thelegend107/H-M-Configuration-Dongle/README.md

# Windows Network Config Dongle
Code Deploy
