thelegend107/H-M-Configuration-Dongle/Block Diagram/block_diagram v2.0.io.png

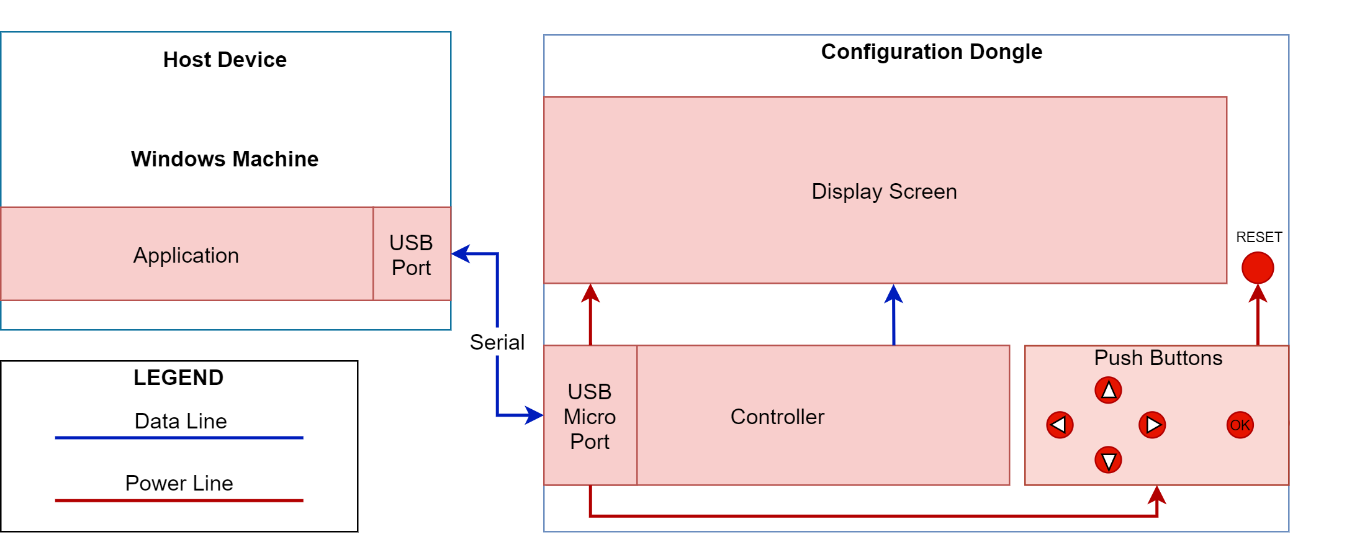
Block Diagram/block_diagram v2.0.io.png
