thelegend107/H-M-Configuration-Dongle/EXPO/Flowcharts & Diagrams/microcontroller process.png

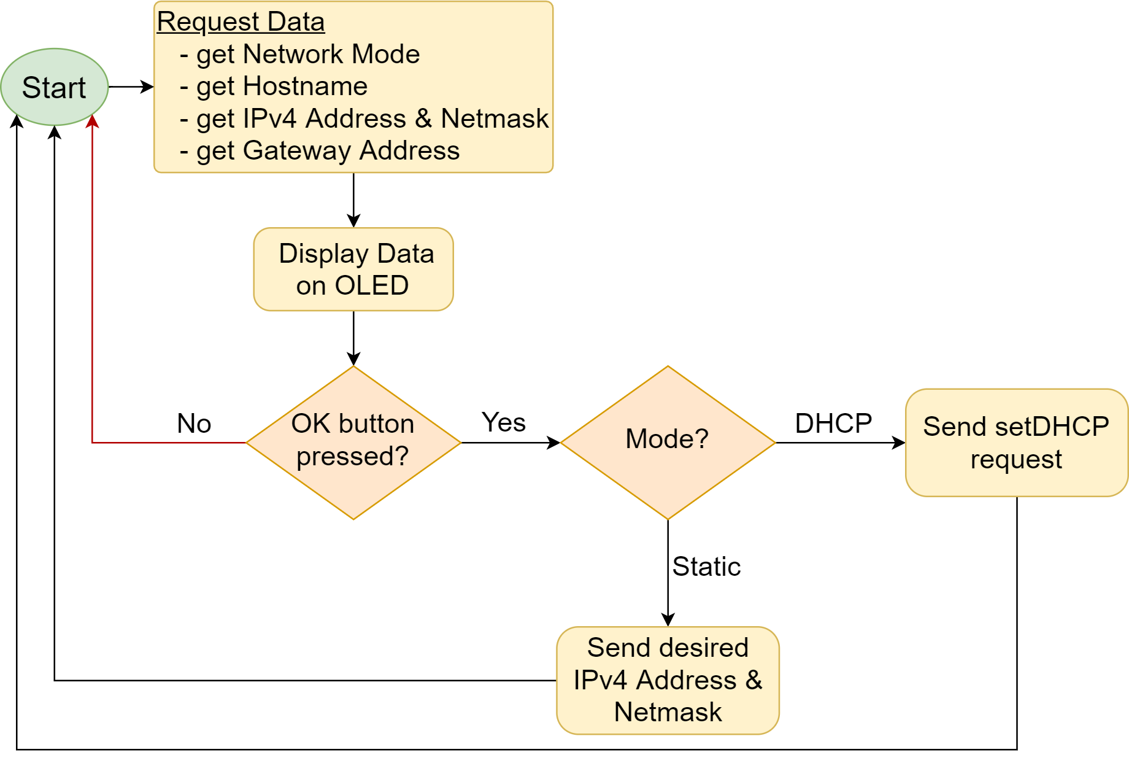
EXPO/Flowcharts & Diagrams/microcontroller process.png
