thelegend107/H-M-Configuration-Dongle/EXPO/Flowcharts & Diagrams/Net_App_Flowchart_noBG.png

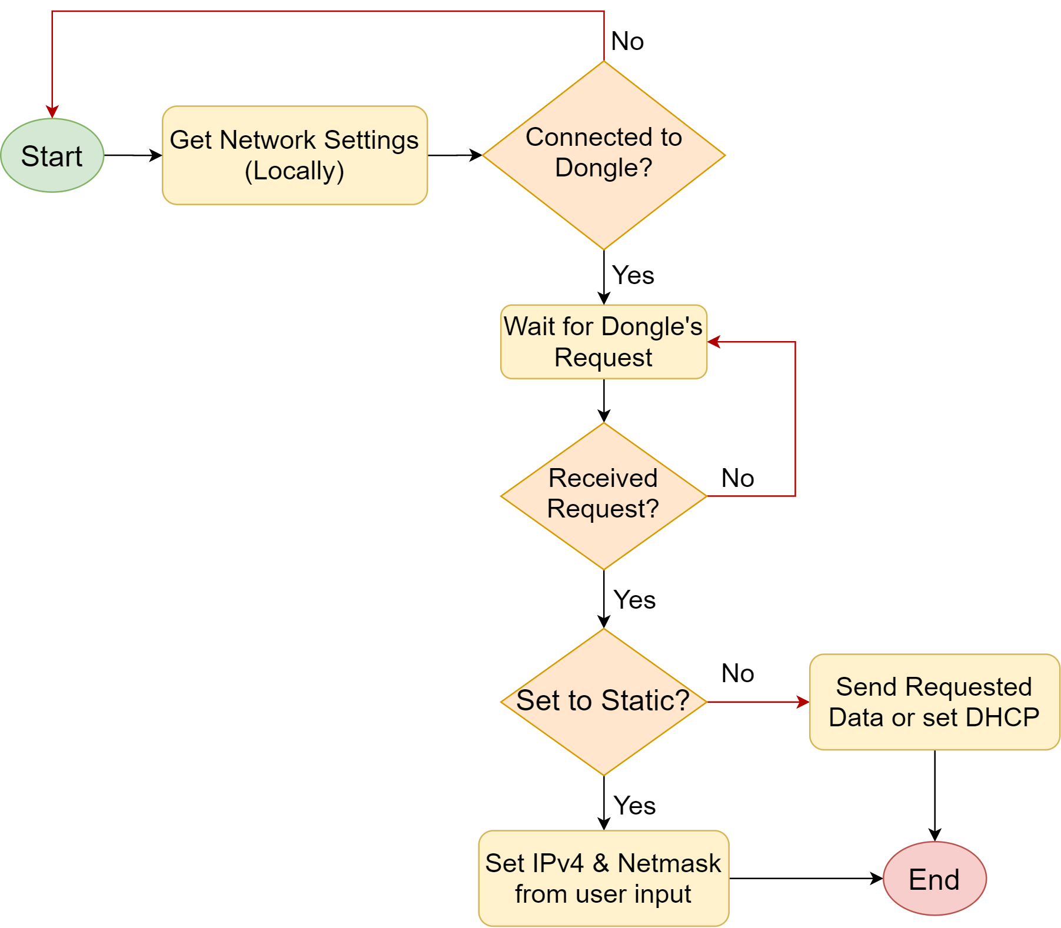
EXPO/Flowcharts & Diagrams/Net_App_Flowchart_noBG.png
