thelegend107/H-M-Configuration-Dongle/PCB/H&M_CD1.png

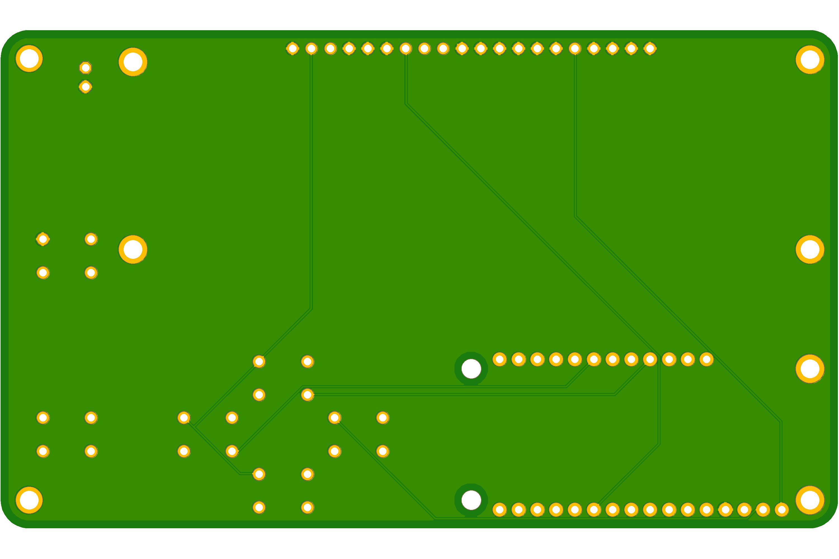
PCB/H&M_CD1.png
