thelegend107/H-M-Configuration-Dongle/PCB/H&M_CD.png

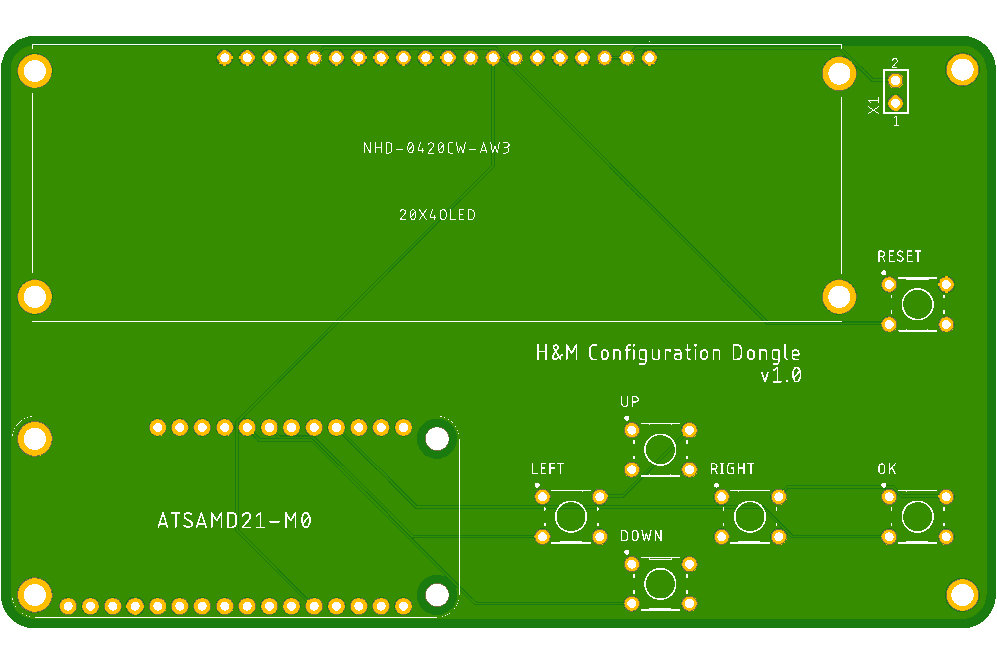
PCB/H&M_CD.png
