thelegend107/H-M-Configuration-Dongle/BOM/H&M_BOM.xlsx

Manufacturer Part Number | Manufacturer | Digi-Key Part Number | Customer Reference | Quantity | Unit Price | Extended Price + Shipping & Tax | Description | Comments | Bought By
N/A | Adafruit Industries LLC | N/A | Amazon.com - BackupMicro-Controller&Misc.pdf | N/A | N/A | $43.89 | Adafruit Backup Microcontroller/OLED/HeaderPins | Backup Microcontroller with HeaderPins | Harsh
N/A | JiaLiChuang (HongKong) Co., Limited | N/A | JLCPCB-v0.1.pdf | 1 | 7.18 | $53.45 | PCB V0.1 | First Version of PCB | Moe
N/A | JiaLiChuang (HongKong) Co., Limited | N/A | JLCPCB-v0.2.pdf | 1 | 4.66 | $40.85 | PCB V0.2 / Final | Second Version of PCB, smaller to meet specs | Harsh
2772 | Adafruit Industries LLC | 1528-1531-ND | Microcontroller1.pdf | 1 | 19.95 | $26.01 | Adafruit Feather M0 Basic Proto - ATSAMD21 Cortex M0 | Microcontroller 1 | Moe
NHD-0420CW-AW3 | Newhaven Display Intl | NHD-0420CW-AW3-ND | OLED-1&Backup1.pdf | 2 | 31.77 | $72.98 | 20 X 4 OLED Module + Backup 1 | OLED Screen + Backup | Moe
NHD-0420CW-AY3 | Newhaven Display Intl | NHD-0420CW-AY3-ND | OLED-Backup2.pdf | 1 | 27.84 | $38.16 | 20 X 4 OLED Module Backup 2 | OLED Screen Backup #2 due to fear that Harsh burned one of the OLED | Moe
B3F-1000 | Omron Electronics Inc-EMC Div | SW400-ND | PCB AssemblyParts & Push Buttons.pdf | 25 | 0.2496 | $32.26 | SWITCH TACTILE SPST-NO 0.05A 24V | For PCB assembly. | Moe
PPTC201LFBN-RC | Sullins Connector Solutions | S7018-ND |  | 5 | 1.23 |  | CONN HDR 20POS 0.1 TIN PCB
PPTC121LFBN-RC | Sullins Connector Solutions | S6100-ND |  | 5 | 0.78 |  | CONN HDR 12POS 0.1 TIN PCB
PPTC161LFBN-RC | Sullins Connector Solutions | S7014-ND |  | 5 | 0.98 |  | CONN HDR 16POS 0.1 TIN PCB
732-3152-6-ND | Würth Elektronik (VA) / 62910416121 | 732-3152-6-ND | USB-B-1.pdf | 2 | 7.33 | $22.49 | CONN RCPT USB2.0 TYPEB 4P SMD RA | Bought initially, but due to our design changes was rendered unused and was too late to return | Moe
732-2108-ND | Würth Elektronik / 61400416121 | 732-2108-ND | USB-B-2.pdf | 5 | 1.32 | $13.05 | CONN RCPT USB2.0 TYPEB 4POS R/A
 |  |  |  |  |  |  |  | Subtotal To Be Reimbursed
 |  |  |  |  |  |  |  | $343.14
