thelegend107/H-M-Configuration-Dongle/BOM/JLCPCB-CommercialInvoice.pdf

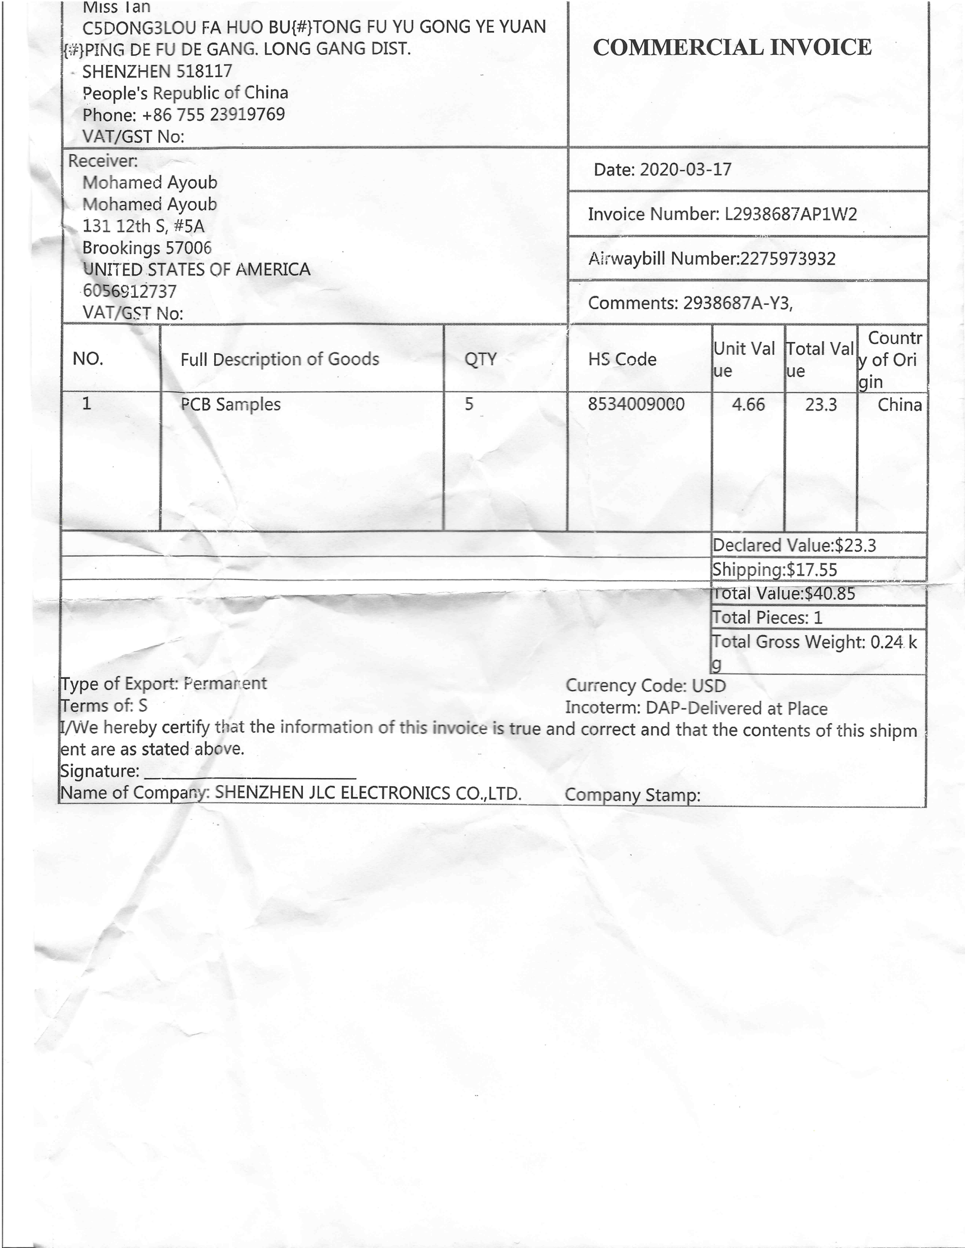
[picture p63: page 1]
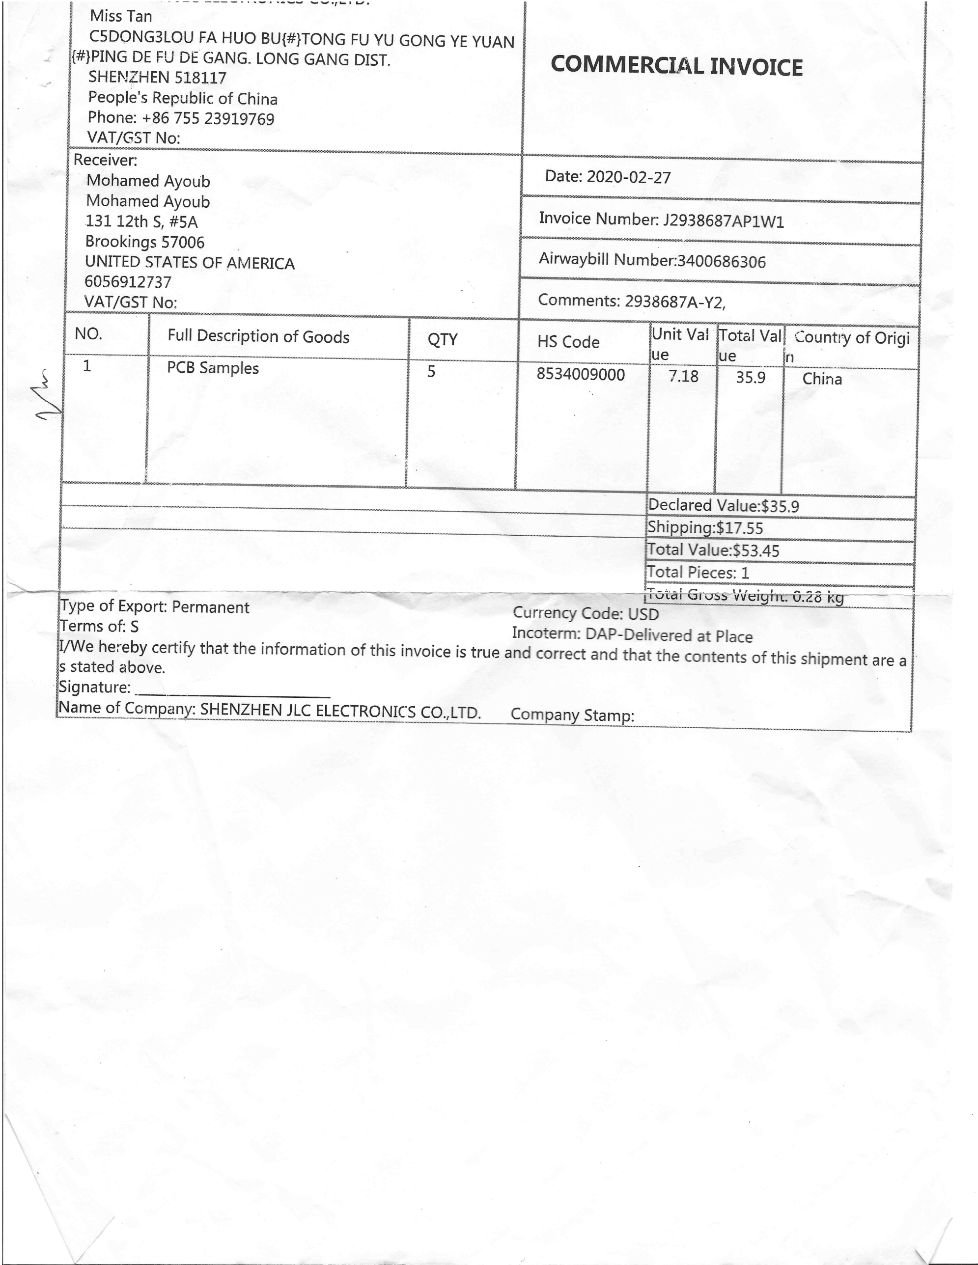
[picture p64: page 2]
