thelegend107/H-M-Configuration-Dongle/BOM/Microcontroller1.pdf

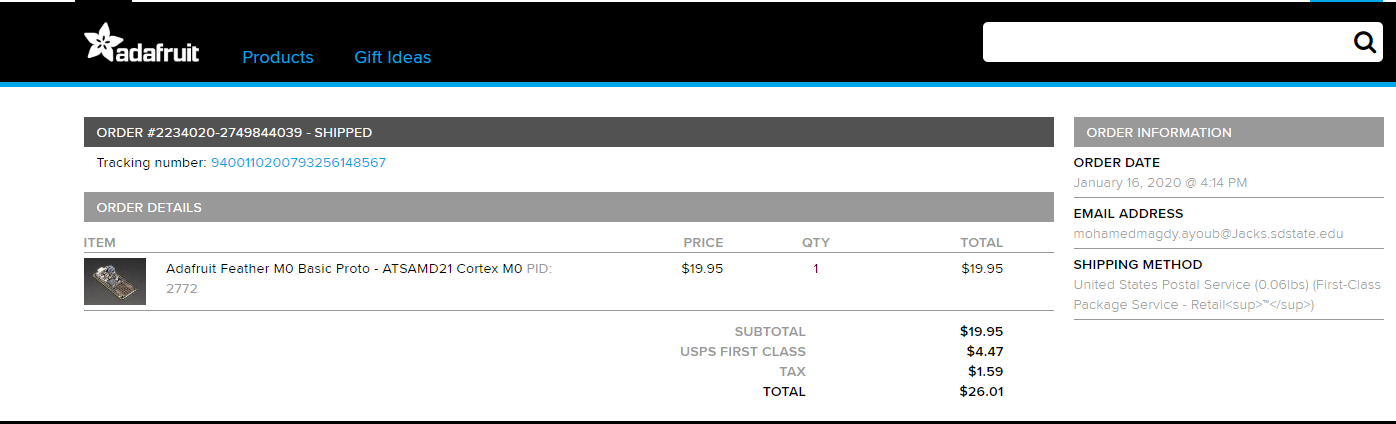
[picture p65: page 1]
