thelegend107/H-M-Configuration-Dongle/PCB/H&M_CD_brd.pdf

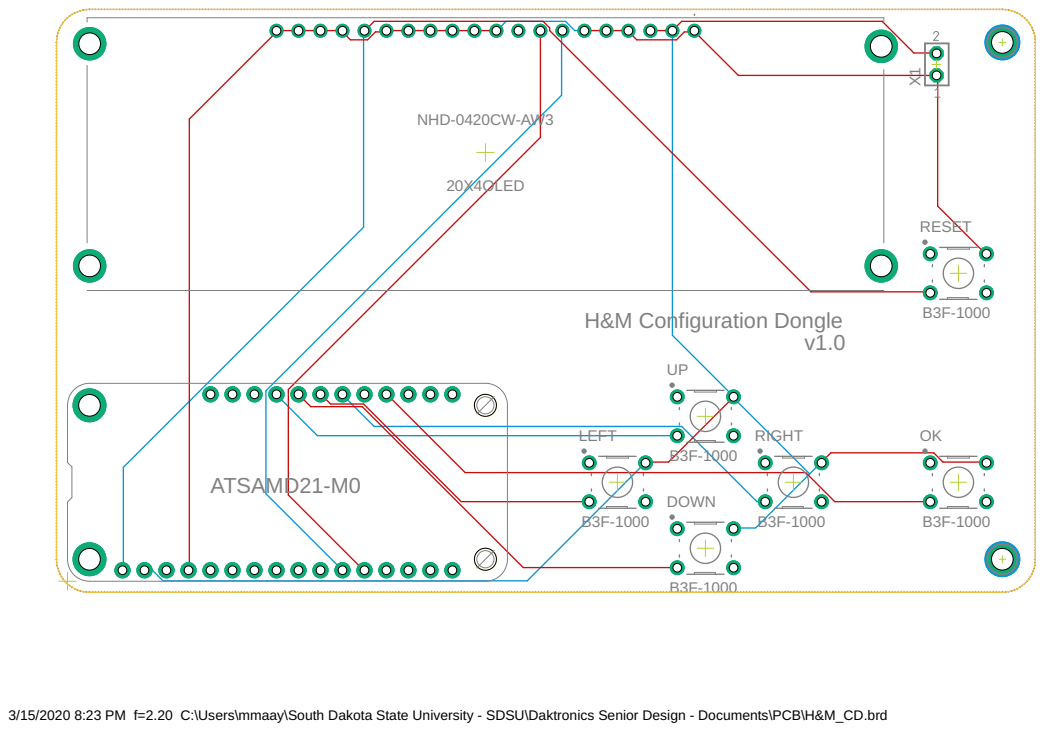
[picture p66: page 1]

3/15/2020 8:23 PM f=2.20 C:\Users\mmaay\South Dakota State University - SDSU\Daktronics Senior Design - Documents\PCB\H&M_CD.brd
