thelegend107/H-M-Configuration-Dongle/PCB/H&M_CD.pdf

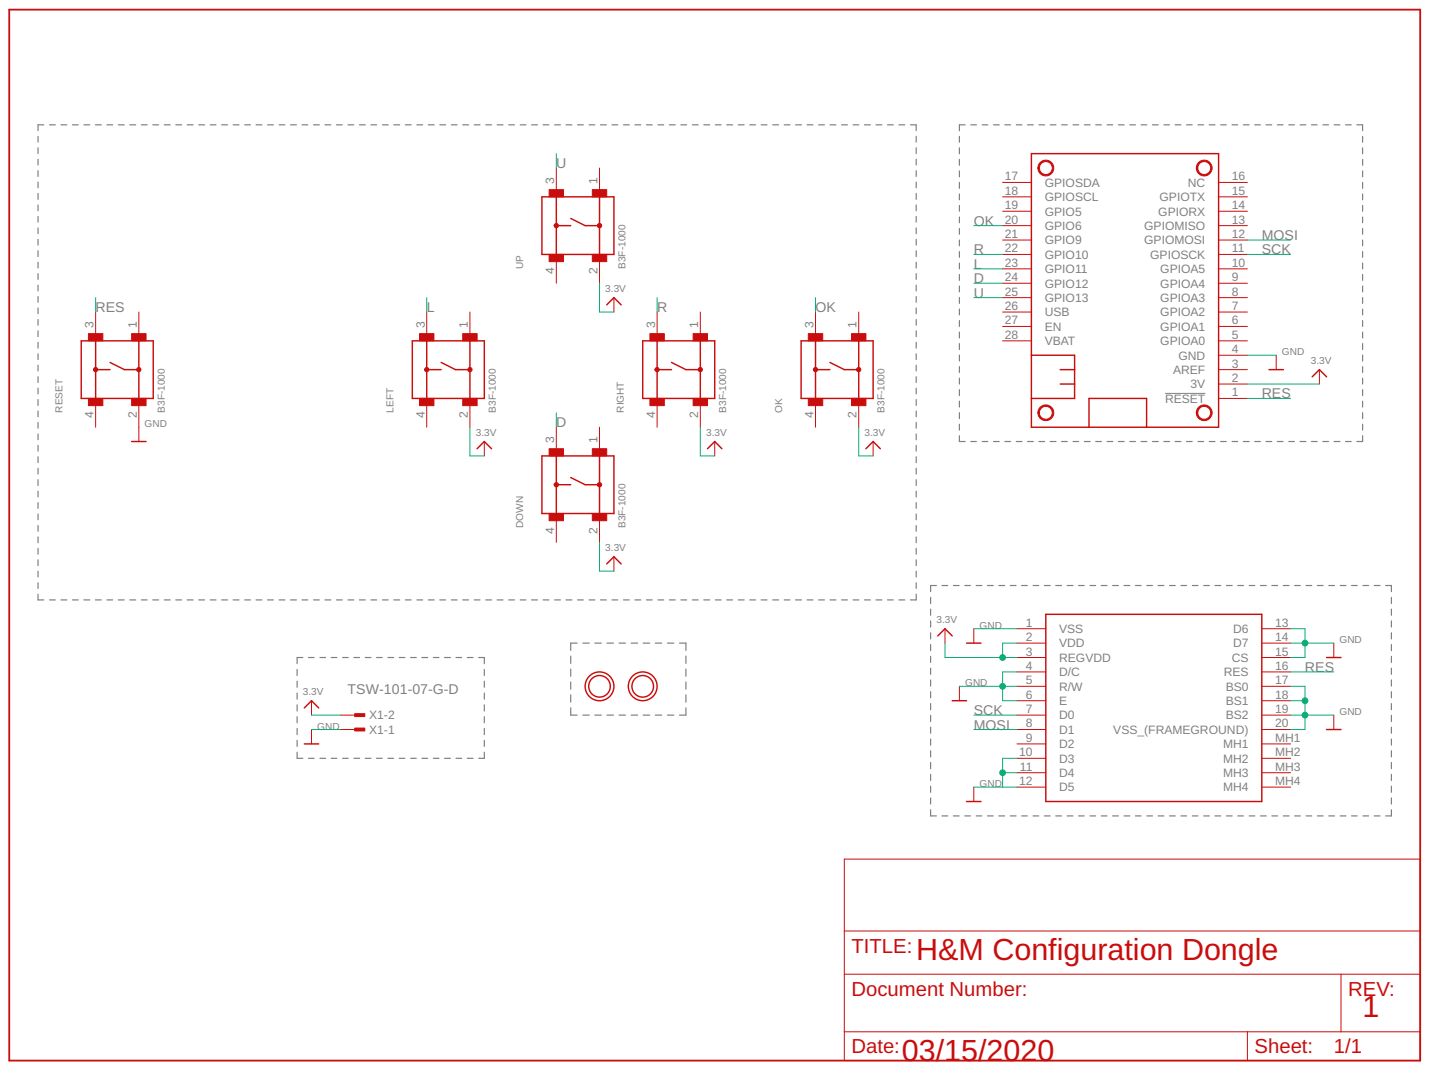
[picture p67: page 1]
