thelegend107/H-M-Configuration-Dongle/PCB/H&M_CD/H&M_CD.brd

## EAGLE design PCB/H&M_CD/H&M_CD.brd (2021-12-26)

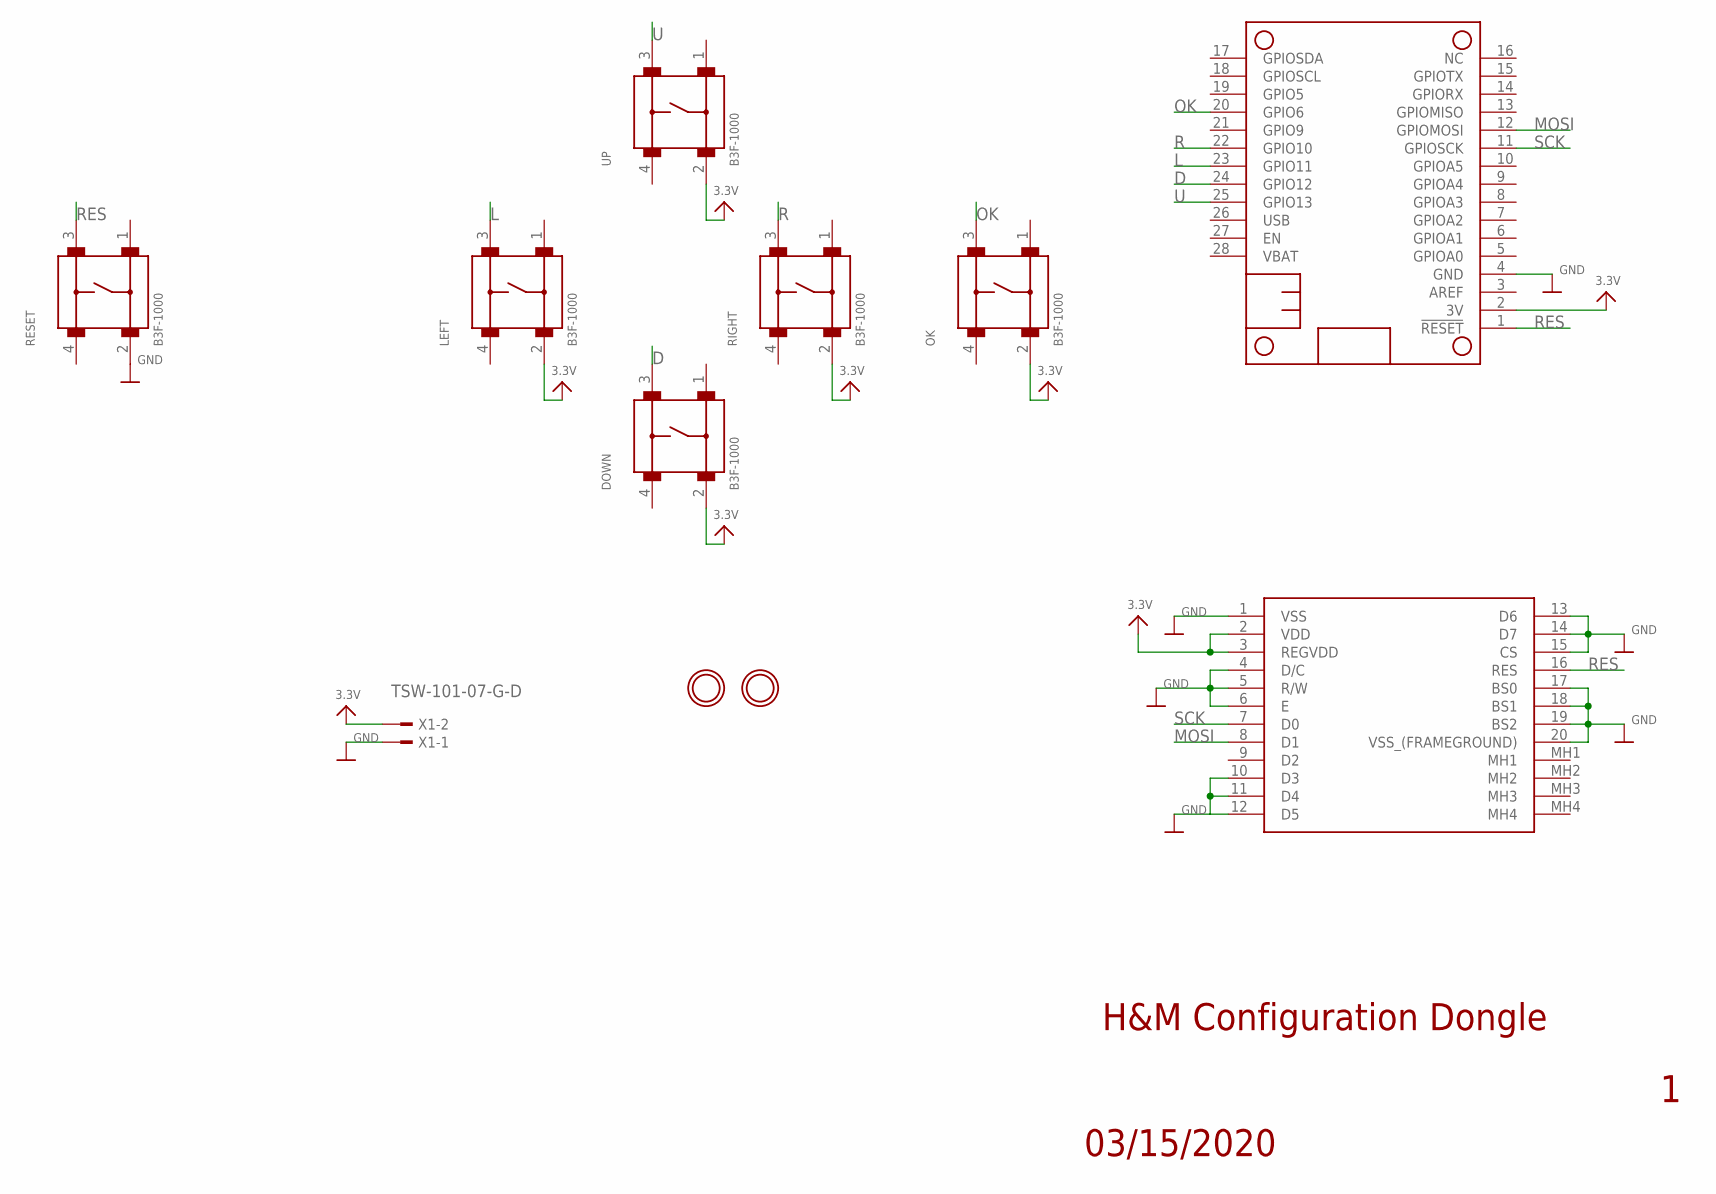
[picture p68: schematic H&M_CD.sch]

Parts:
20X4OLED: NHD-0420CW-AW3; NHD0420CWAW3
ATSAMD21M0: FEATHERWING_NODIM; FEATHERWING_DIM
DOWN: B3F-1000
LEFT: B3F-1000
OK: B3F-1000
RESET: B3F-1000
RIGHT: B3F-1000
U$15, U$16: MOUNTINGHOLE2.5; MOUNTINGHOLE_2.5_PLATED
UP: B3F-1000
X1: TSW-101-07-G-D; TSW-101-XX-G-D

Connections:
3.3V: 20X4OLED.2 (VDD), 20X4OLED.3 (REGVDD), ATSAMD21M0.2 (3V), DOWN.2, LEFT.2, OK.2, RIGHT.2, UP.2, X1.2
D: ATSAMD21M0.24 (GPIO12), DOWN.3
GND: 20X4OLED.1 (VSS), 20X4OLED.4 (D/C), 20X4OLED.5 (R/W), 20X4OLED.6 (E), 20X4OLED.10 (D3), 20X4OLED.11 (D4), 20X4OLED.12 (D5), 20X4OLED.13 (D6), 20X4OLED.14 (D7), 20X4OLED.15 (CS), 20X4OLED.17 (BS0), 20X4OLED.18 (BS1), 20X4OLED.19 (BS2), 20X4OLED.20 (VSS_(FRAMEGROUND)), ATSAMD21M0.4 (GND), RESET.2, X1.1
L: ATSAMD21M0.23 (GPIO11), LEFT.3
MOSI: 20X4OLED.8 (D1), ATSAMD21M0.12 (GPIOMOSI)
OK: ATSAMD21M0.20 (GPIO6), OK.3
R: ATSAMD21M0.22 (GPIO10), RIGHT.3
RES: 20X4OLED.16 (RES), ATSAMD21M0.1 (!RESET), RESET.3
SCK: 20X4OLED.7 (D0), ATSAMD21M0.11 (GPIOSCK)
U: ATSAMD21M0.25 (GPIO13), UP.3

Notes on the sheet:
03/15/2020
H&M Configuration Dongle

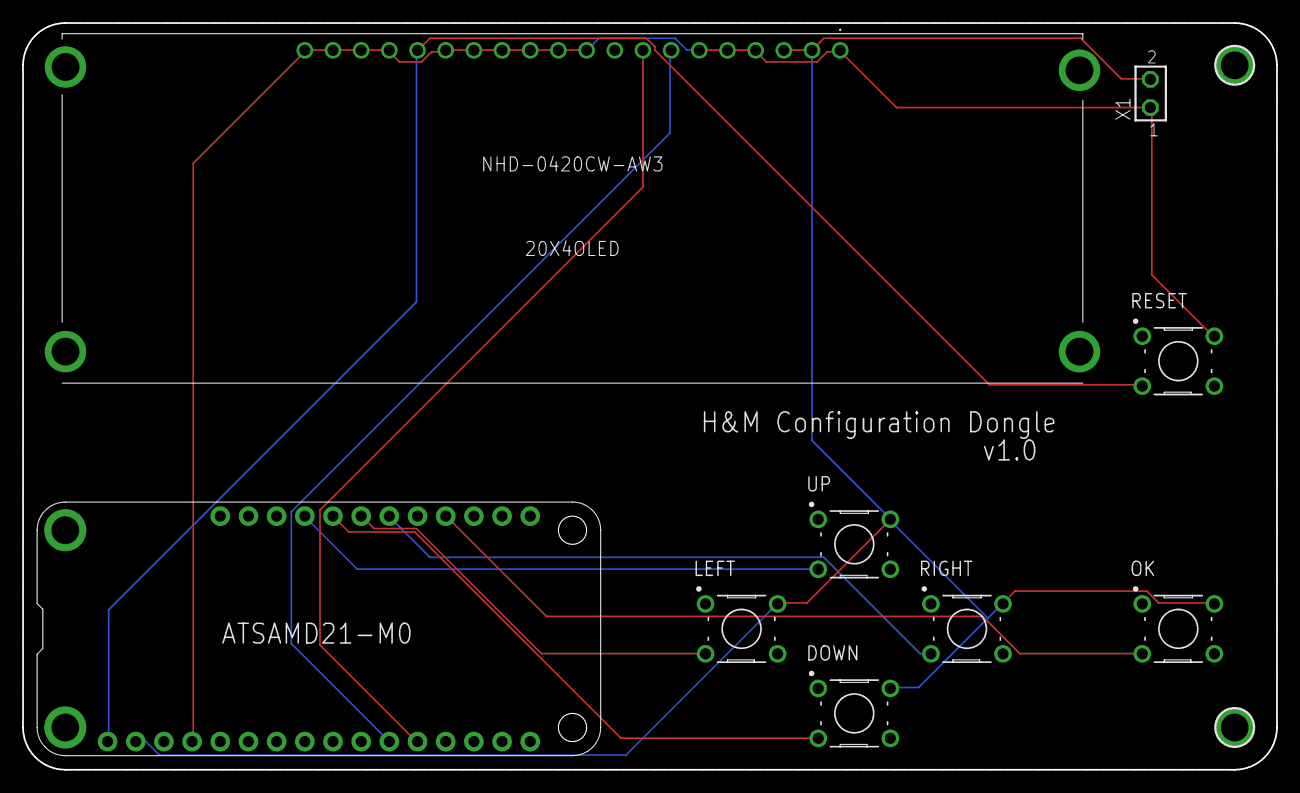
[picture p69: board H&M_CD.brd from above]

Board: 2 copper layers, 113.0 x 67.3 mm, 11 parts (0 on the bottom side), 10 nets.
